preston11-tamu/ECEN404-2026SP-Team-61-HARD/README.md

# TEAM-61-HARD
ECEN 404 Capstone Project: Human Activity Radar Detector (HARD)
