preston11-tamu/ECEN404-2026SP-Team-61-HARD/Power/ALTIUM/README

#Altium files used in the most updated version of power supply
