preston11-tamu/ECEN404-2026SP-Team-61-HARD/Power/MISC/README

#This Contains Random Files which may not have a good spot to be held otherwise but stored in case anyone wants to recreat this project
