preston11-tamu/ECEN404-2026SP-Team-61-HARD/403/presentations/Group 61 Status Update Presentation.pptx

## ECEN 403 Status Update


Team 61: HARD
William Jachimiak, Jean Jacques Chirat, Preston Bowyer, Aiden George
TA: Roman Venegas
Sponsor: Professor Arya Menon

## Project Summary

Problem statement:
- Injury from falling is common in assisted living and can lead to significant issues
- Traditional camera based sensors violate individual’s right to privacy
Our Solution:
- A human fall detector that uses short wave radio and sends alerts via an app
- These detectors can be used in more sensitive areas and prevent privacy violations


## Slide 3

System Overview

Human Radar Unit

Power Supply (Aiden George)

Millimeter Wave Radar Unit

Microcontroller (William Jachimiak)

Neural Network Classification (JJ Chirat)

End User

Mobile Application
(Preston Bowyer)

Firebase Cloud Service

Shared PCB

Deployed on MCU

Flutter Framework

Notes: Cloud server and database

## Machine Learning (Neural Network) Jean Jacques Chirat

Accomplishments since midterm update 40 hrs of effort | Ongoing progress/problems and plans until the next presentation
Finished implementing preprocessing code - binary to .json conversion, calibrating for training parameters, feature scaling | Finish implementing code for neural network Collect ~40 datasets (30 for training, 10 for testing) Train model, evaluate loss & accuracy, set benchmark by the end of this week

## Machine Learning (Neural Network) Jean Jacques Chirat

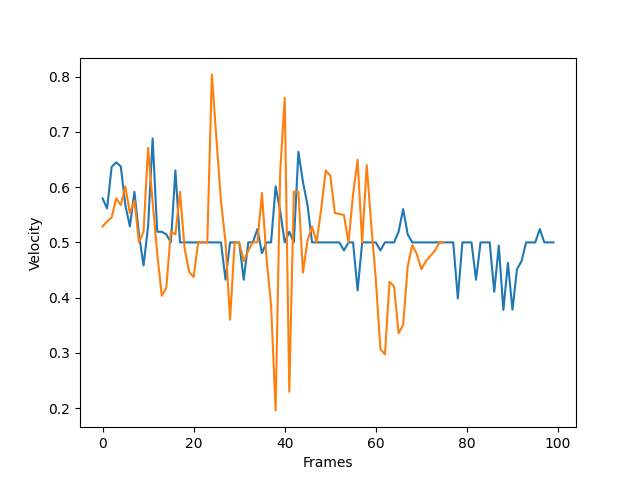
[picture p15: figure]

Data visualized
- Orange is falling pattern
- Blue is non-falling pattern

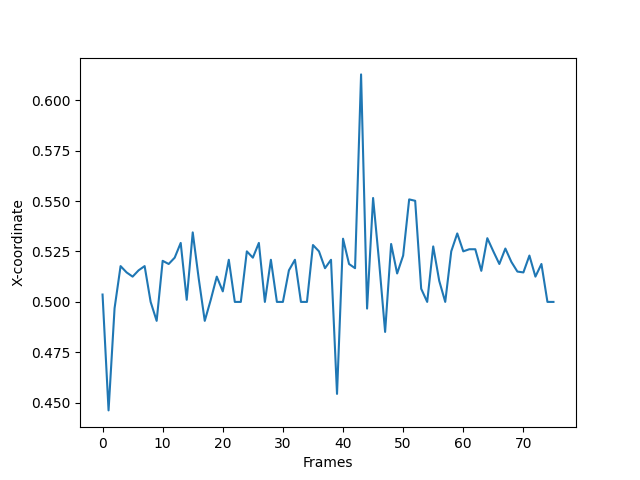
[picture p16: figure]

Falling pattern
- Left is x-coordinate (orientated so that “x” is vertical)
- Right is doppler velocity

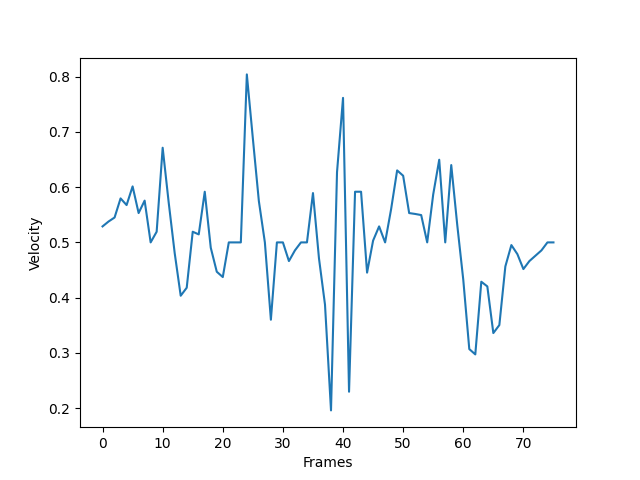
[picture p17: figure]

## MCU/PCB William Jachimiak

Accomplishments since midterm update 40 hrs of effort | Ongoing progress/problems and plans until the next presentation
Finished the schematics tied to the PCB | Finishing the routing of the PCB Plan to start working on getting WIFI output signals from MCU

## MCU/PCB William Jachimiak

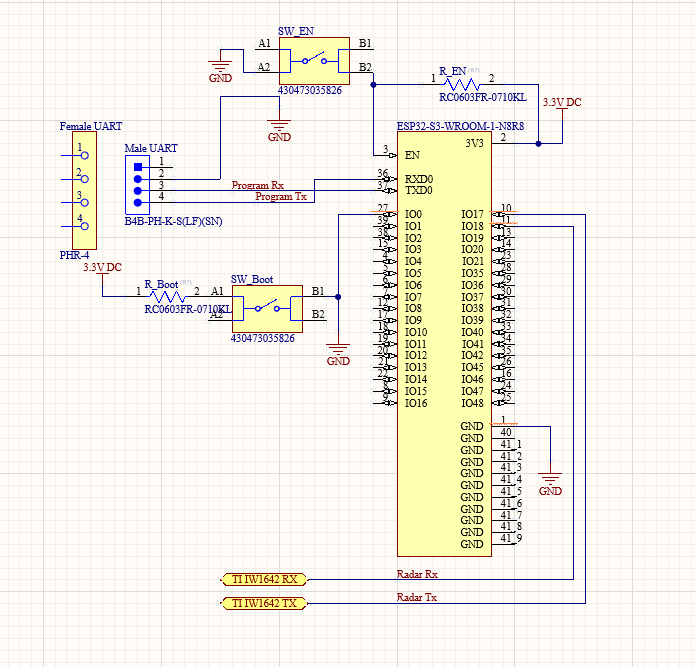
[picture p18: figure]

MCU Schematic

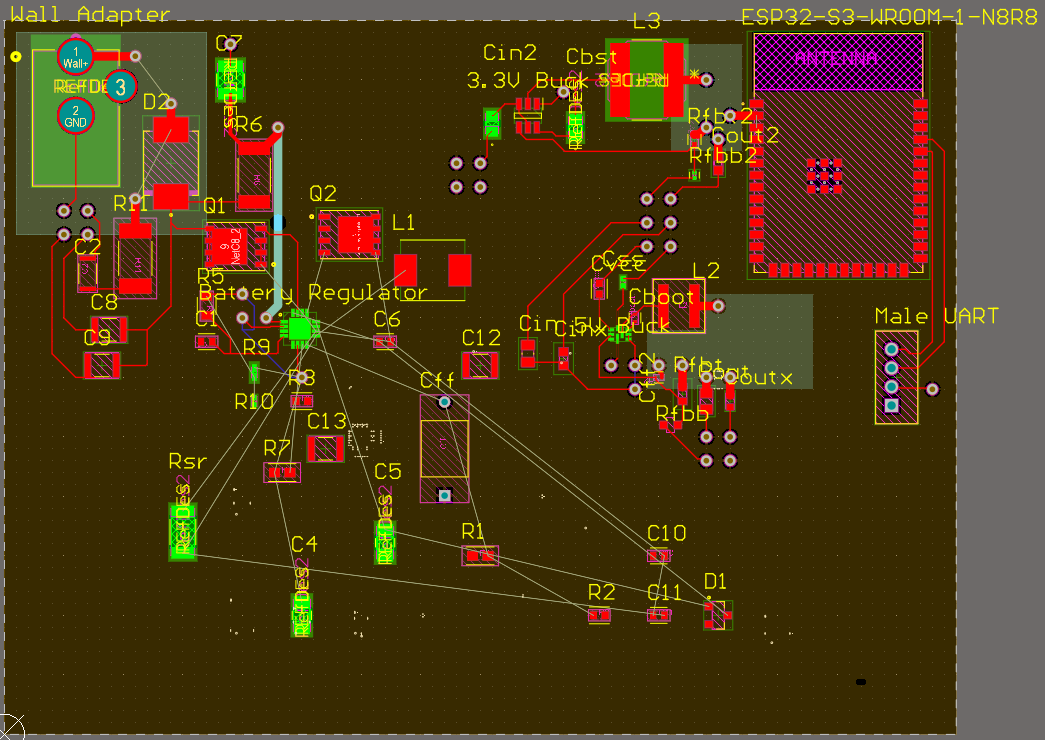
[picture p19: figure]

Current PCB Layout

## Power Supply Aiden George

Accomplishments since midterm update 40 hrs of effort | Ongoing progress/problems and plans until the next presentation
Researched and designed battery charger IC for power supply design Finialized power supply design for PCB Implementation Conducted PSpice simulation of components to validate design for use case

## Subsystem 3 Aiden George

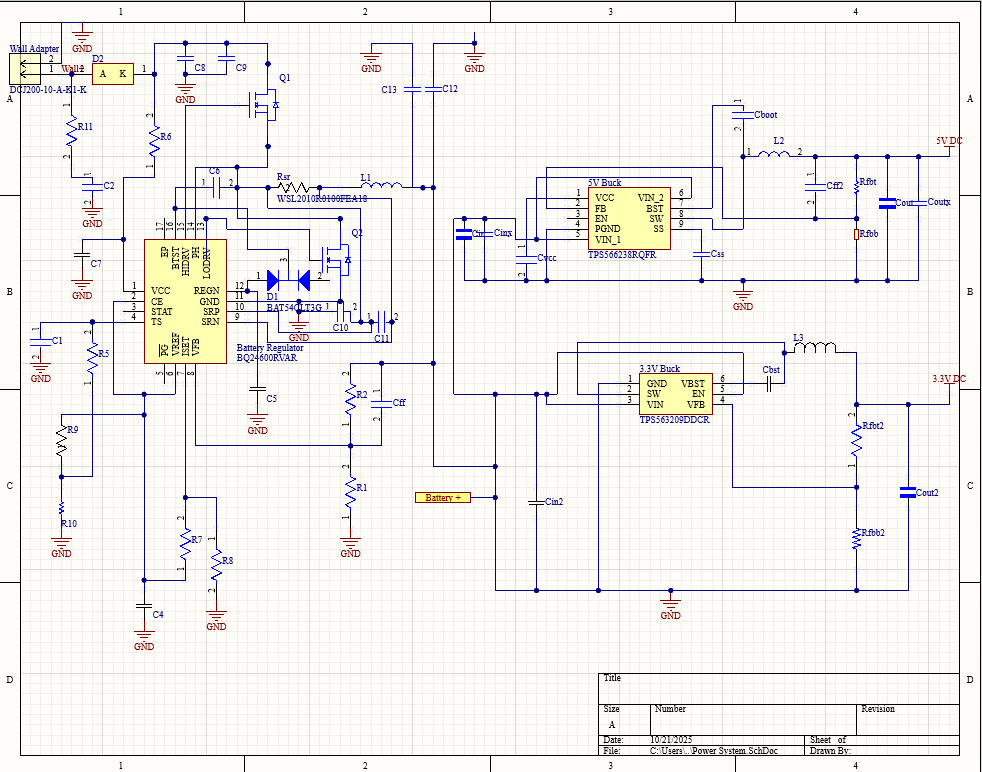
[picture p20: figure]

Power Schematic

## End-User App Preston Bowyer

Accomplishments since midterm update 40 hrs of effort | Ongoing progress/problems and plans until the next presentation
Developed the main UI and successfully deployed the app to an Android device Integrated Firebase Cloud Messaging for real-time alerts on Android Built Firestore alert feed with All, Unread, and Critical filters | Deploy Cloud Function to automatically send FCM alerts for critical events Debugging and validating end-to-end notification reliability across app states and device types Updating the UI to a modern, sleeker look,and planning pagination for for alerts

## End-User App Preston Bowyer

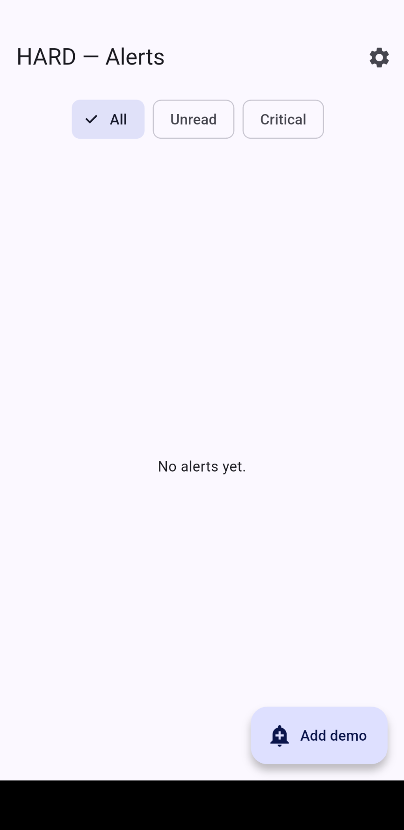
[picture p21: figure]

Cleared alerts page

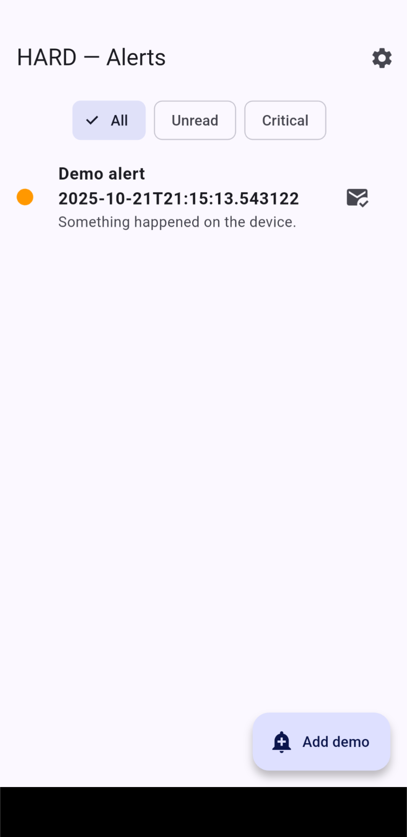
[picture p22: figure]

Alerts page with demo

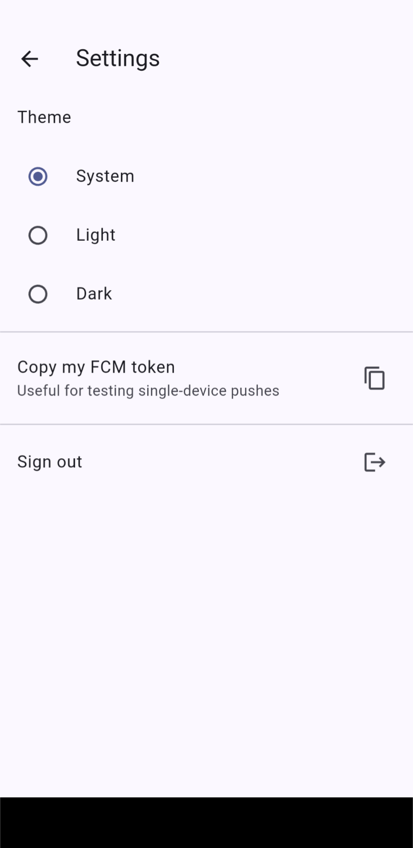
[picture p23: figure]

Settings page

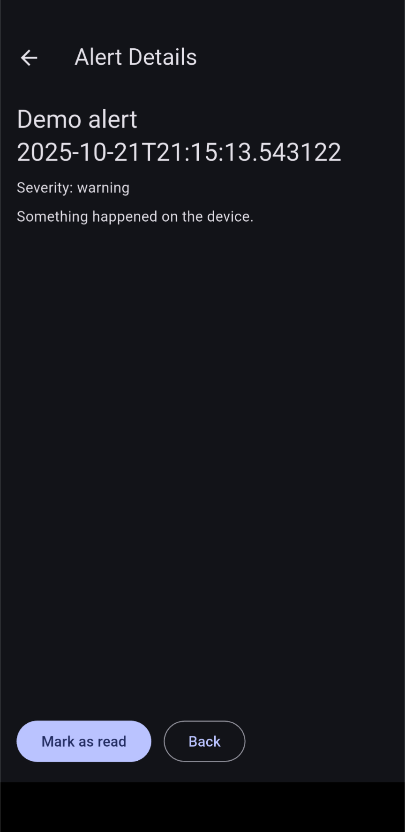
[picture p24: figure]

Dark mode and alert details

## Execution Plan

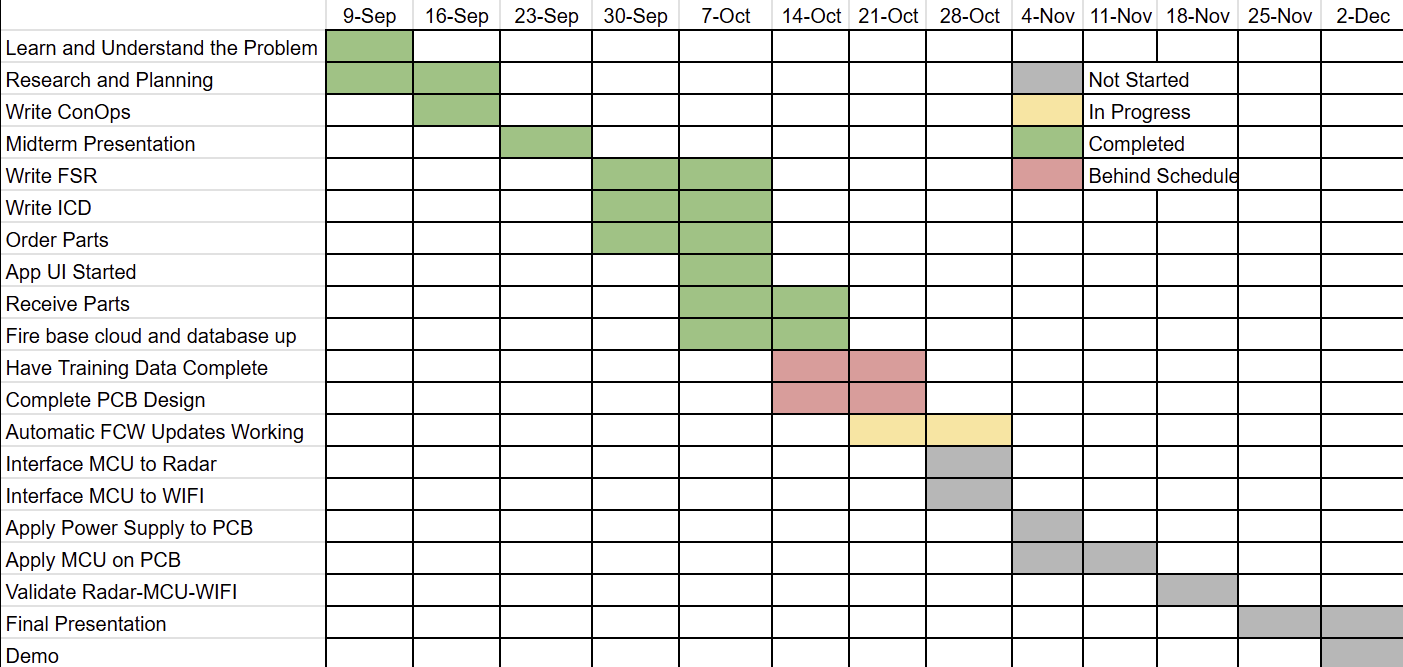
[picture p25: figure]

‹#›

## Validation plan

Task | Specification | Owner
Peak Power | 10 W | Aiden
Radar Detect Distance | 8 M | All
Detection False Positive Rate | ≤ 8% | JJ/William
Detection False Negative Rate | ≤ 5% | JJ/William
Push Notification delivery success | ≥ 99% | Preston
Multi-device fan-out | ± 300ms spread | Preston

‹#›

## Slide 14

Thank you for listening!
Questions & Answers

‹#›
