preston11-tamu/ECEN404-2026SP-Team-61-HARD/404/presentations/Group 61 Status Update #2 ECEN 404.pptx

## Team 61: Project Name Bi-Weekly Update 2 William Jachimiak, Jean Jacques Chirat, Preston Bowyer, Aiden George Sponsor: Professor Arya Menon TA: Manoj Kumar Balamurugan


Notes: Michelle

## Project Summary

- Our project seeks to solve the problem of monitoring fall injury prone individuals in assisted-care through the following implementation:
- Collection of vertical position & velocity data (minimally invasive) using mmWave radar
- Stream the data to Raspberry Pi to be processed by ML detection algorithm
- Pi communicates positive detection result over WiFi network to Firebase cloud
- Firebase interfaces with Android app to notify assisted-care workers if fall event occurs


Notes: Kyle

## Project/Subsystem Overview


Notes: Eric

## Project Timeline

Subsystem Designs and Testing (completed 02/05) | Integration of SBC and ML (to complete by 02/20) | Integration of SBC and App (to complete by 02/20) | Final Integration (to complete by 03/05) | System Test (to complete by 03/26) | Validation (to complete by 04/02) | Demo and Report (to complete by 04/21)

Notes: Eric

## MCU/SBC William Jachimiak

Accomplishments since last update 15 hrs of effort | Ongoing progress/problems and plans until the next presentation
Sent alert over WiFi to the Firebase cloud and created a class to run continuously Ongoing integration with ML | Verifying data transfer to the machine learning class Testing fall detection using real time data

## MCU/SBC William Jachimiak

## Machine Learning Subsystem Jean Jacques Chirat

Accomplishments since last update 8 hrs of effort | Ongoing progress/problems and plans until the next presentation
Adapted existing code onto MCU for ML dataflow Implemented new class & function on MCU to do inferencing on real-time data | Verify that data is 1:1 with model input format Verify that MCU is able to compute prediction result within specified time limit Validate entire data pipeline from radar to ML output (while actually operating)

## Machine Learning Subsystem Jean Jacques Chirat

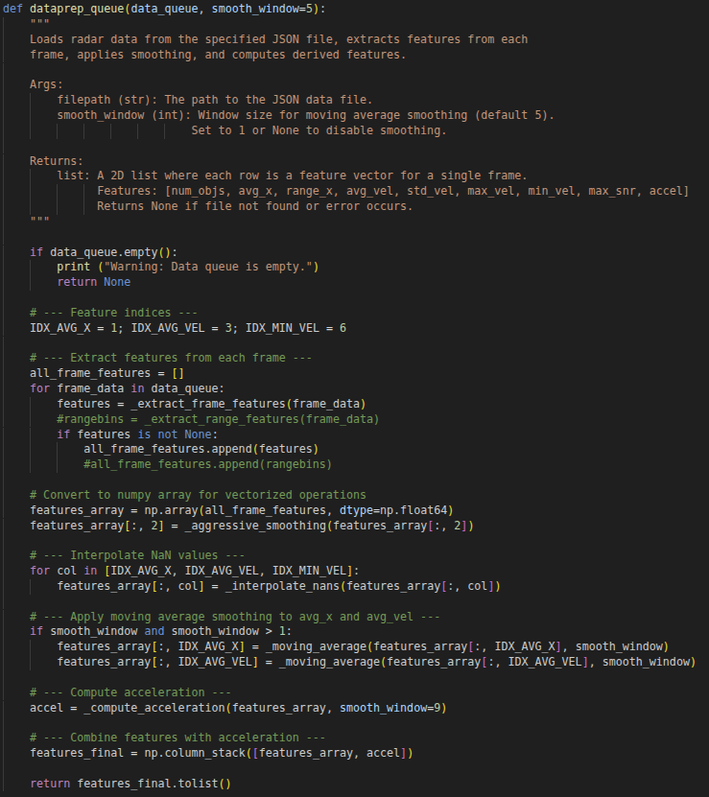
[picture p61: figure]

Preprocessing code adapted for MCU

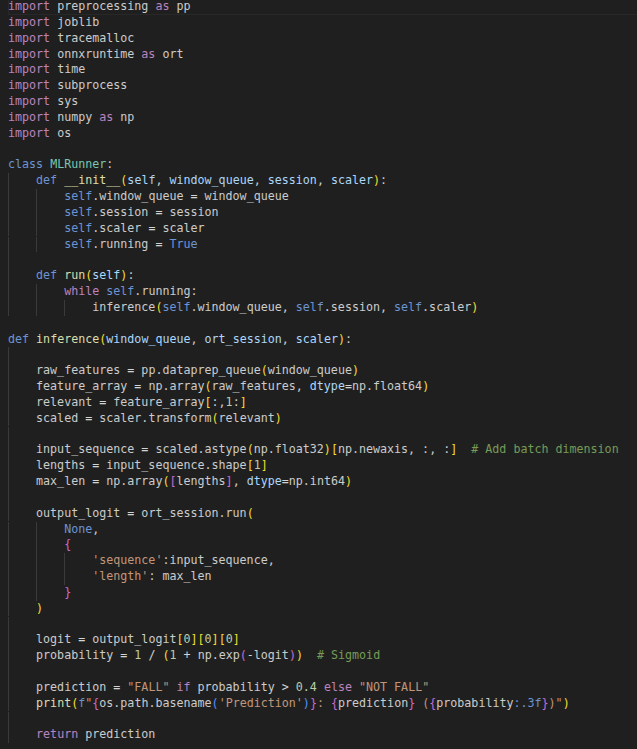
[picture p62: figure]

New code for

## Power Supply Aiden George

Accomplishments since last update 25 hrs of effort | Ongoing progress/problems and plans until the next presentation
Finished redesign and integration of battery charger IC Ordered for parts and board Created CAD design for system enclosure and mounting bracket design for parts | Complete soldering of board and begin validation of design Finish MCU and Radar Bracket Mounts 3D print initial model and ensure fitting of parts

## Power Supply Aiden George

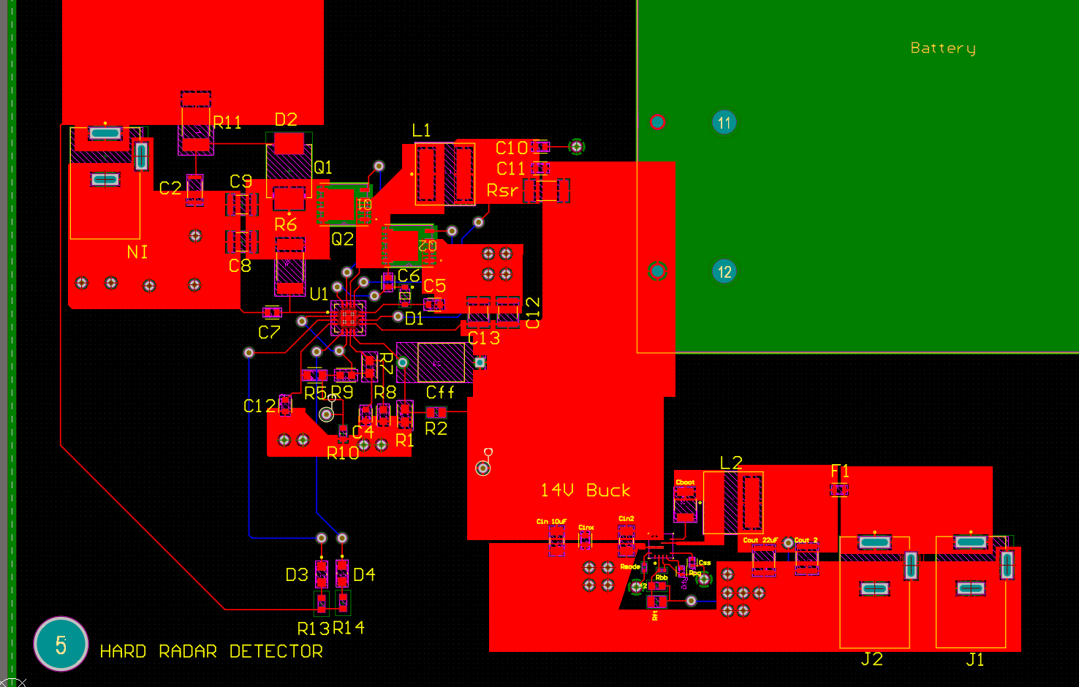
[picture p63: figure]
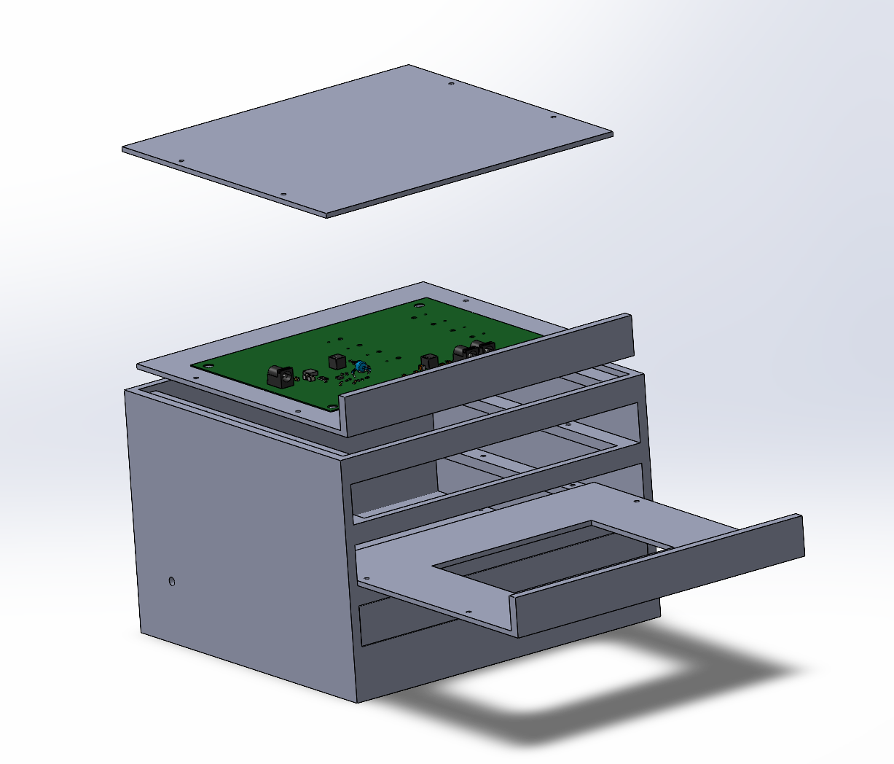
[picture p64: figure]

## End User App Preston Bowyer

Accomplishments since last update 13 hrs of effort | Ongoing progress/problems and plans until the next presentation
Implemented the pipeline for the Raspberry Pi to publish detection and alert data to the cloud backend. Validated that alert data generated on the Pi is reliably written to the database. | Integrating Firestore publishing into the Raspberry Pi’s main detection runtime Refactoring the current standalone publishing script into a reusable module Automating execution on startup to remove manual intervention

## End User App Preston Bowyer

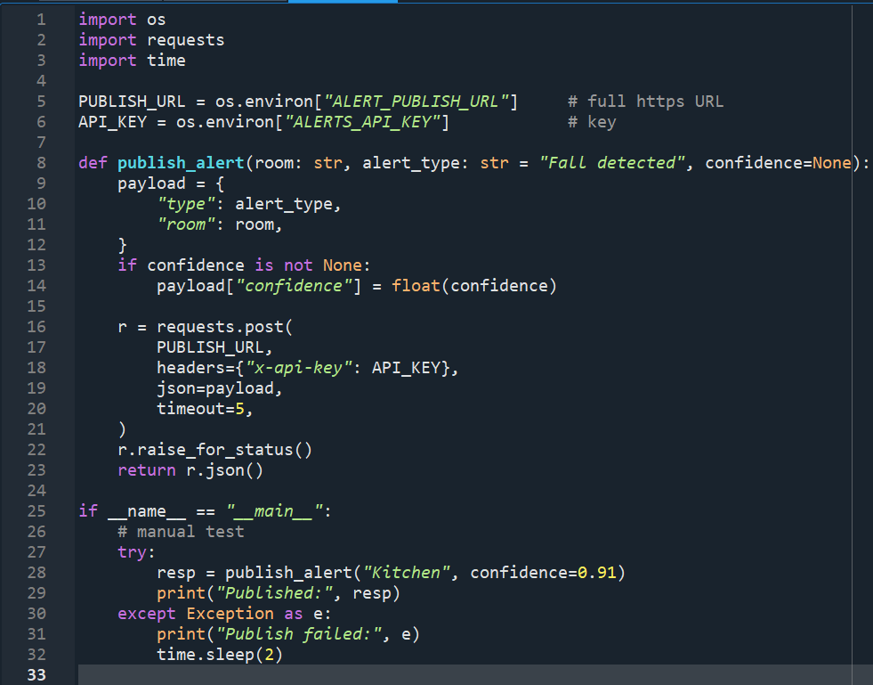
[picture p65: figure]
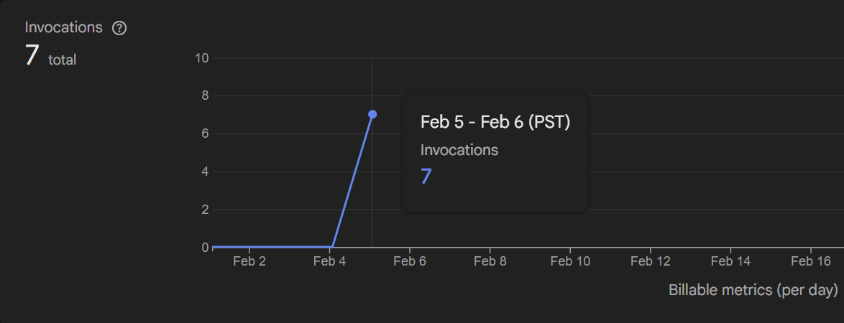
[picture p66: figure]
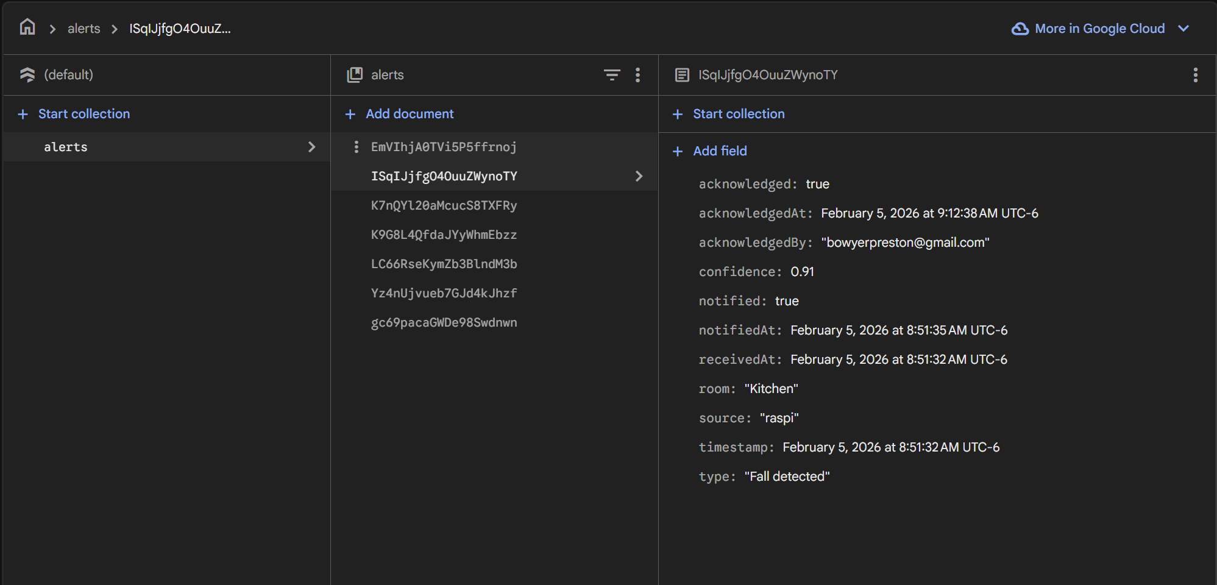
[picture p67: figure]

## Execution Plan

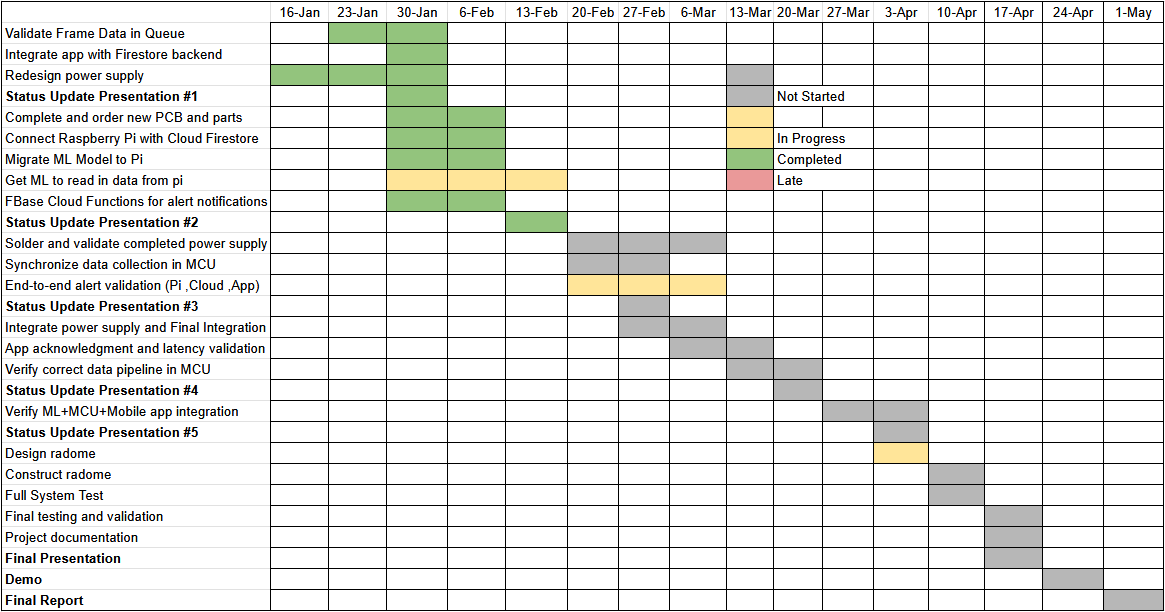
[picture p68: figure]

Notes: Michelle

## Validation Plan

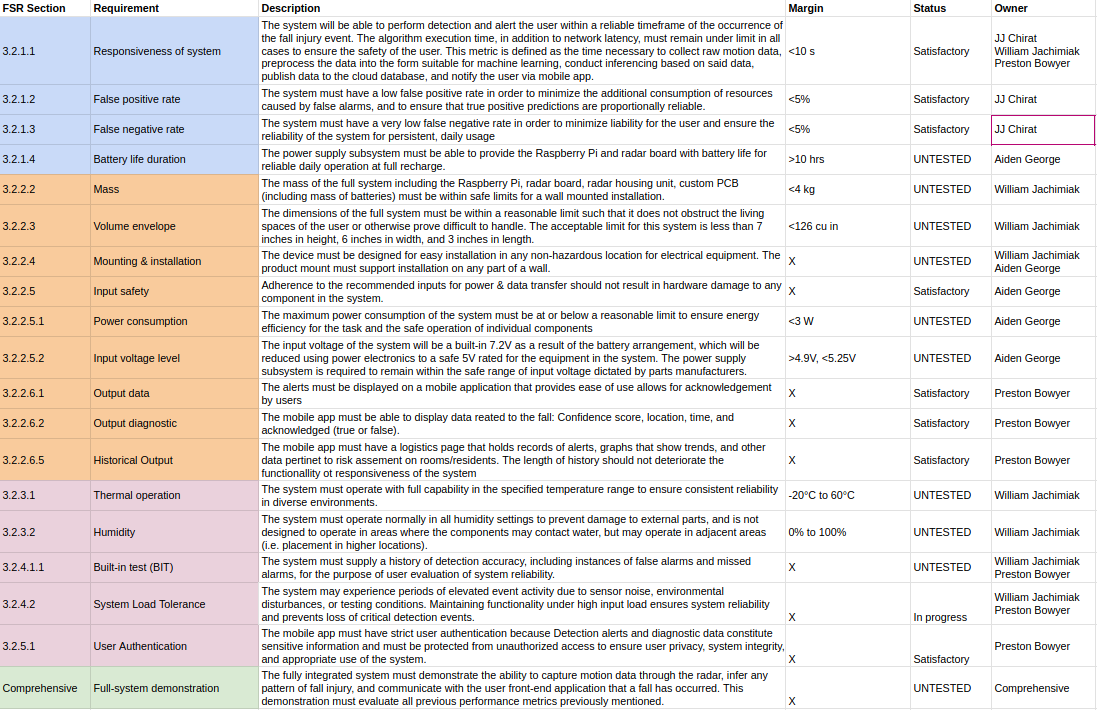
[picture p69: figure]

Notes: Michelle

## Thank you for listening! Q&A
