preston11-tamu/ECEN404-2026SP-Team-61-HARD/403/documents/Power Supply Diagram.jpg

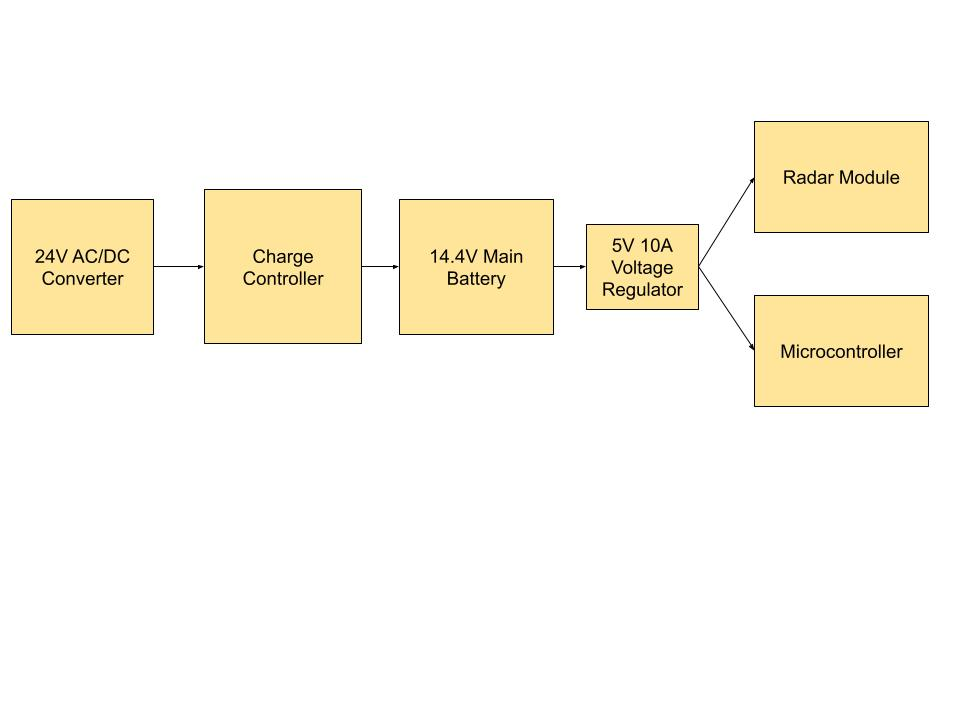
403/documents/Power Supply Diagram.jpg
