preston11-tamu/ECEN404-2026SP-Team-61-HARD/ML/dbscan_animation.gif

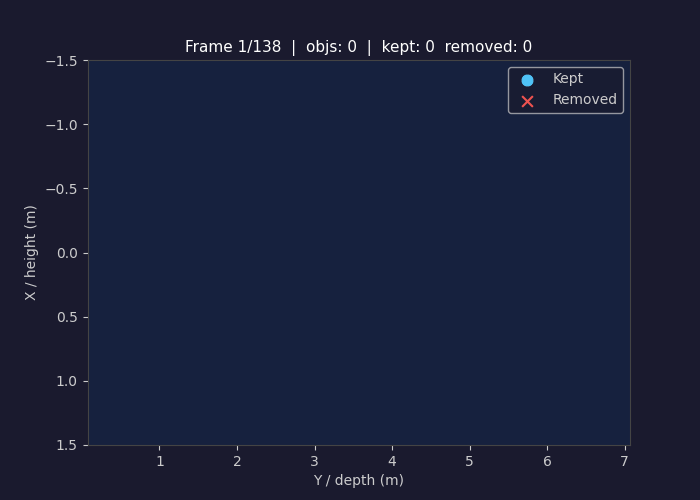
ML/dbscan_animation.gif
