preston11-tamu/ECEN404-2026SP-Team-61-HARD/ML/final_training_loss.png

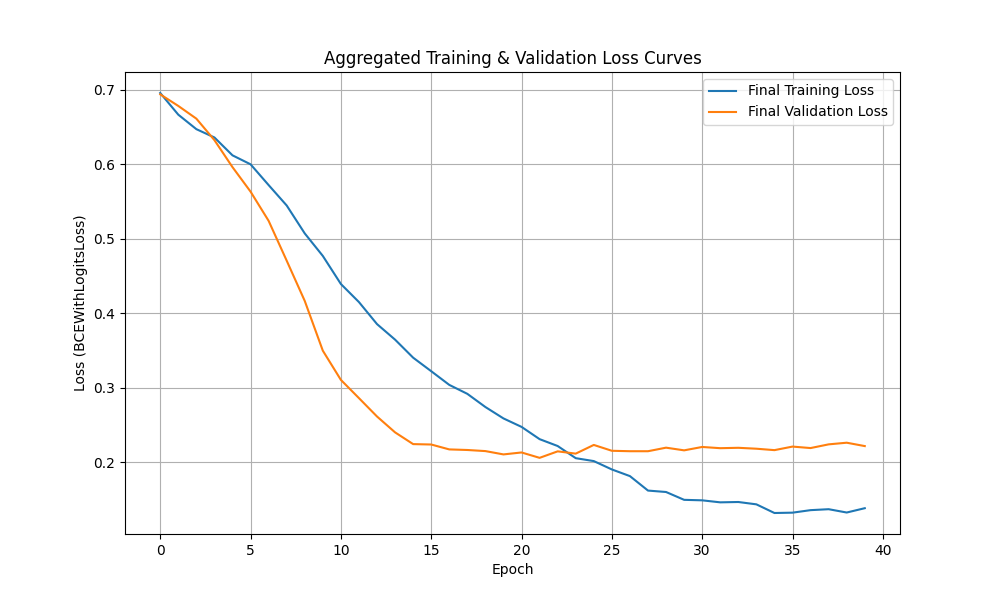
ML/final_training_loss.png
