preston11-tamu/ECEN404-2026SP-Team-61-HARD/ML/fold_accuracy.png

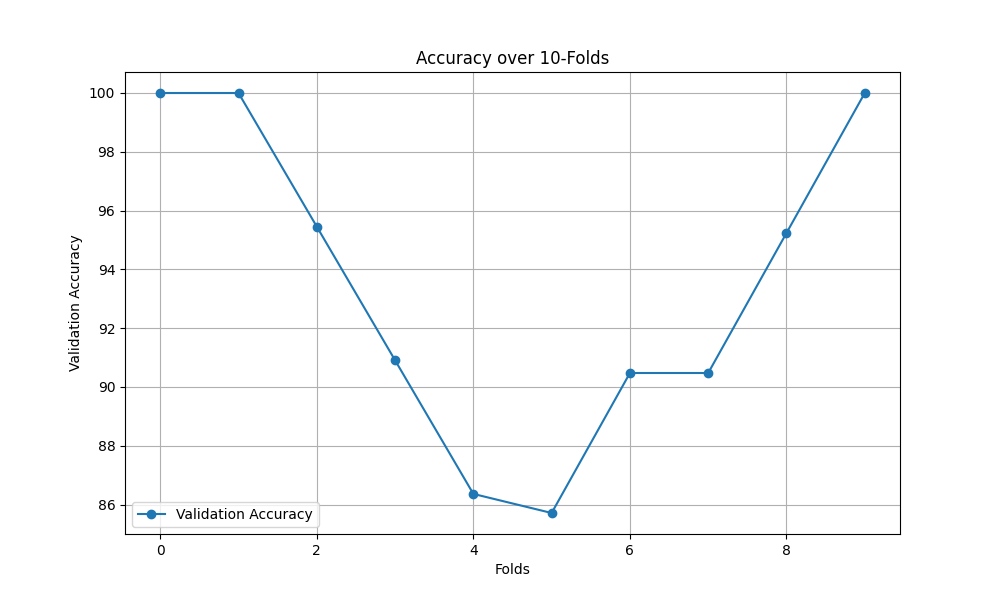
ML/fold_accuracy.png
