preston11-tamu/ECEN404-2026SP-Team-61-HARD/Power/MISC/Capstone V2 BOM.xlsx

 | Description | Designator | Footprint | LibRef | Quantity
Comment | 4.5V to 28V input, 10A synchronous buck converter 10-VQFN-HR -40 to 150 | 14V Buck | RPA0010A-MFG | TPS56A37RPAR | 1
BK-18650-PC8 | No Description Available | Battery | BK-18650-PC8_MPD | BK-18650-PC8 | 1
CGA5L3X7R1H225K160AB | Cap Ceramic 2.2uF 50V X7R 10% Pad SMD 1206 +125°C Automotive T/R | C2 | FP-CGA5L-0_3-0_1-IPC_C | CMP-08246-002495-1 | 1
CC0603KRX7R8BB105 | CAP CER 1UF 25V X7R 0603 | C4, C5 | FP-CC0603-DA-MFG | CMP-2100-03598-2 | 2
C0603C104K4RAC7411 | CAP CER 0.1UF 16V X7R 0603 | C6, C7, C11 | FP-C0603C-CF-MFG | CMP-2006-03724-3 | 3
GRM32ER7YA106KA12L | Chip Capacitor, 10 uF, +/- 10%, 35 V, -55 to 125 degC, 1210 (3225 Metric), RoHS, Tape and Reel | C8, C9, C12, C13 | CAPC3225X270X30LL30 | CMP-1038-02234-2 | 4
C0603C104K5RACTU | CAP CER 0.1UF 50V X7R 0603 | C10 | FP-C0603C-CF-MFG | CMP-2006-03061-2 | 1
CC0603KRX7R8BB104 | CAP CER 0.1UF 25V X7R 0603 | C12 | FP-CC0603-DA-MFG | CMP-03422-000234-1 | 1
C3225X6S1C226M250AC | Multilayer Ceramic Capacitors 22uF ±20% 16V X6S SMD 1210 | Cboot | FP-C3225-250-0_4-MFG | CMP-08246-006992-1 | 1
DE11XRB220KN4AR01F | Cap Ceramic Disc 22pF 10% 500VAC Thru-Hole 6.0x5.0x10.0 Ammo pack | Cff | FP-DE1_D6_T5_F10_d0_6-0_0-MFG | CMP-06035-012369-1 | 1
C0603C151K3GACTU |  | Cff2 | CAPC1608X87X35NL15T15 | CMP-2006-03084-1 | 1
Comment | Chip Multilayer Ceramic Capacitors for General Purpose, 1206, 10uF, X7R, 15%, 10%, 25V | Cin2, Cin 10uF | FP-GRM31C-0_2-e0_3_0_8-IPC_C | CMP-06035-003589-1 | 2
C0603C104M3VACTU | CAP CER 0.1UF 25V Y5V 0603 | Cinx | FP-C0603C-CF-MFG | CMP-2006-03066-2 | 1
Cin | Multilayer Ceramic Capacitors 22uF ±20% 16V X6S SMD 1210 | Cout 2 | FP-C3225-250-0_4-IPC_C | CMP-08246-006992-1 | 1
FEMTOASMDC005F-2 | Multilayer Ceramic Capacitors 22uF ±20% 16V X6S SMD 1210 | Cout 22uF | FP-C3225-250-0_4-IPC_C | CMP-08246-006992-1 | 1
GRM155R71C223KA01D | Chip Multilayer Ceramic Capacitors for General Purpose, 0402, 22000pF, X7R, 15%, 10%, 16V | Css | FP-GRM155-0_05-MFG | CMP-1034-01948-3 | 1
BAT54HT1G | Schottky Barrier Diode, 2-Pin SOD-323, Pb-Free, Tape and Reel | D1 | ONSC-SOD-323-2-477-02_V | CMP-1055-00462-1 | 1
MBRS540T3G | Schottky Power Rectifier, 2-Pin SMC, Pb-Free, Tape and Reel | D2 | ONSC-SMC-2-403-03_V | CMP-1055-00390-1 | 1
LTST-C170GKT | LED GREEN CLEAR SMD | D3, D4 | FP-LTST-C170GKT-MFG | CMP-1674-00002-6 | 2
FEMTOASMDC005F-2 | fuse 0603 | F1 | FP-MCT0603-IPC_C | CMP-02407-009727-1 | 1
PJ-002A | Through Hole Right Angle DC Power Jack, 2.5 A, 2 mm Center Pin, 3 Position, -25 to 85 degC, RoHS, Bulk | IN, J1, J2 | CUI-PJ-002A_V | CMP-2000-06895-2 | 3
XAL7070-332 | Fixed Inductors 3.3uH Shld 20% 25A 2.81mOhms AECQ2 | L2 | FP-XAL7070-MFG | CMP-11268-000195-1 | 1
XAL7070-222 | Fixed Inductors 2.2uH Shld 20% 25A 2.81mOhms AECQ2 | L? | FP-XAL7070-MFG | CMP-11268-000195-1 | 1
SIR426DP-T1-GE3 | N-CHANNEL 40-V (D-S) MOSFET | Q1, Q2 | POWERPAK_SO-8_SINGLE | SIR426DP-T1-GE3 | 2
RR0816P-104-D | 100kΩ ±0.5% 0.0625W 1/16W Chip Resistor 0603 (1608 Metric) Thin Film | R1, R7 | FP-RR0816-IPC_A | CMP-2000-02426-2 | 2
ERA-6AEB6983V | Metal Film Chip Resistor, High Reliability Type, 0.125 W, +/- 0.1%, -55 to 155 degC, 0805 (2012 Metric), RoHS, Tape and Reel | R2 | RESC2013X60X40LL20T25_A | CMP-2001-00582-2 | 1
RR0816P-101-D | 100Ω ±0.5% 0.0625W 1/16W Chip Resistor 0603 (1608 Metric) Thin Film | R5 | FP-RR0816-MFG | CMP-2000-02416-2 | 1
RMCF2512JT10R0 | 10Ω ±5% 1W 2512 Thick Film Chip Resistor AEC-Q200 compliant | R6 | FP-RMCF2512-IPC_B | CMP-26527-002316-1 | 1
ERA-3AEB4122V | RES SMD 9.31KOHM 0.1% 1/10W 0603 | R8 | FP-ERA3A-IPC_B | CMP-05422-000141-1 | 1
ERA-3AEB9311V | RES SMD 9.31KOHM 0.1% 1/10W 0603 | R9 | FP-ERA3A-IPC_B | CMP-05422-000141-1 | 1
442K 1% 0603(1608) | 442K 0.1W 1% 0603 (1608 Metric) SMD | R10 | RESC0603(1608)_L | CMP-1012-00809-1 | 1
RMCF2512JT2R00 | 2Ω ±5% 1W 2512 Thick Film Chip Resistor AEC-Q200 compliant | R11 | FP-RMCF2512-IPC_A | CMP-26527-006700-1 | 1
RC0603JR-0710KL | 10K 0.05W 1% 0201 (0603 Metric) SMD | R13, R14 | RESC1608X55X25ML10T15 | CMP-2000-05022-1 | 2
10K 1% 0201(0603) |  | Rbb | RESC0201(0603)_N | CMP-1010-00642-1 | 1
ERJ-6ENF7322V |  | Rft | RESC2013X70X40LL20T20 | CMP-2001-00287-1 | 1
CRCW040252K3FKED |  | Rmode | RESC1005X40X25LL05T05 | CMP-2002-00086-1 | 1
CRCW0402100KFKED | RES Thick Film, 100kΩ, 1%, 0.063W, 100ppm/°C, 0402 | Rpg | FP-CRCW0402-e3-IPC_C | CMP-2002-08123-3 | 1
WSL2010R0100FEA | Chip Resistor, 10 mOhm, +/- 1%, 0.5 W, -65 to 170 degC, 2010 (5025 Metric), RoHS, Tape and Reel | Rsr | RESC5125X89X51LL25T25 | CMP-2000-07418-1 | 1
BQ24600RVAT | IC SYNC SW-MODE BAT CHRGR 16VQFN | U1 | FP-RVA0016A-MFG | CMP-0321-00211-3 | 1
