preston11-tamu/ECEN404-2026SP-Team-61-HARD/403/documents/Copy of ECEN 403 Budget  (1).xlsx

 | Components Cost
 | Mouser # | Mfr. # | Manufacturer | Customer # | Description | RoHS | Lifecycle | Order Qty. | Price (USD) | Ext.: (USD) | Estimated Tariff Price (USD) | Estimated Tariff Ext. (USD)
1 | 595-TPS566238RQFR | TPS566238RQFR | Texas Instruments |  | Switching Voltage Regulators 3-V to 18-V input 6 -A synchronous step- | RoHS Compliant |  | 3 | $0.96 | $2.88 | $0.54 | $1.61
2 | 595-TPS563209DDCR | TPS563209DDCR | Texas Instruments |  | Switching Voltage Regulators 17 V Input 3A SOT-2 3 6-SOT -40to85 A 595-TPS563209DDCT | RoHS Compliant |  | 3 | $1.02 | $3.06 | $0.57 | $1.71
3 | 781-SIR426DP-GE3 | SIR426DP-T1-GE3 | Vishay |  | MOSFETs 40V Vds 20V Vgs PowerPAK SO-8 | RoHS Compliant By Exemption |  | 6 | $1.26 | $7.56 | $0.71 | $4.24
4 | 637-BAT54C | BAT54C | Diotec Semiconductor |  | Schottky Diodes & Rectifiers Schottky, SOT-23, 30V, 0.2A | RoHS Compliant |  | 1 | $0.12 | $0.12 | $0.07 | $0.07
5 | 863-MBRS540T3G | MBRS540T3G | onsemi |  | Schottky Diodes & Rectifiers 5A 40V | RoHS Compliant By Exemption |  | 3 | $0.40 | $1.20 | $0.07 | $0.20
6 | 71-WSL2010-0.01-E3 | WSL2010R0100FEB | Vishay |  | Current Sense Resistors - SMD 1/2watt .01ohms 1% | RoHS Compliant |  | 3 | $1.61 | $4.83
7 | 595-BQ24600RVAR | BQ24600RVAR | Texas Instruments |  | Battery Management Standalone Synch Sw- mode Charge Cntrlr A 595-BQ24600RVAT | RoHS Compliant |  | 3 | $2.25 | $6.75
8 | 954-103AT-2 | 103AT-2 | Semitec |  | NTC Thermistors 10kohm 1% | RoHS Compliant By Exemption |  | 3 | $0.58 | $1.74
9 | 70-IHLP2525CZR3R3M8A | IHLP2525CZER3R3M8A | Vishay |  | Power Inductors - SMD 3.3uH 20% | RoHS Compliant |  | 3 | $1.06 | $3.18 | $0.60 | $1.81
10 | 963-GMJ316BB7106KLHT | GMJ316BB7106KLHT | TAIYO YUDEN |  | Multilayer Ceramic Capacitors MLCC - SMD/SMT 963-MCJCG31LBB7106KT RPLCMT PN 35V 10uF X7R 1206 AEC-Q200 | RoHS Compliant |  | 10 | $0.46 | $4.61
11 | 963-MLASE168SB7105KT | MLASE168SB7105KTNA01 | TAIYO YUDEN |  | Multilayer Ceramic Capacitors MLCC - SMD/SMT 16V 1uF X7R 0603 10% Medical | RoHS Compliant |  | 2 | $0.11 | $0.22 | $0.05 | $0.11
12 | 603-AC1206KKX7R9BB22 | AC1206KKX7R9BB225 | YAGEO |  | Multilayer Ceramic Capacitors MLCC - SMD/SMT 50V 2.2uF X7R 1206 10% AEC-Q200 HI CV | RoHS Compliant |  | 1 | $0.78 | $0.78
13 | 810-C1608X7R1H105K08 | C1608X7R1H105K080AB | TDK |  | Multilayer Ceramic Capacitors MLCC - SMD/SMT Commercial Grade,MLCC,0603,X7R,50V,1uF,+/-10%,0.8mm | RoHS Compliant | New Product | 1 | $0.23 | $0.23 | $0.04 | $0.04
14 | 603-CC402KRX7R7BB104 | CC0402KRX7R7BB104 | YAGEO |  | Multilayer Ceramic Capacitors MLCC - SMD/SMT 16 V 0.1uF X7R 0402 10% | RoHS Compliant |  | 4 | $0.10 | $0.40
15 | 581-04025C220KAT2A | 04025C220KAT2A | KYOCERA AVX |  | Multilayer Ceramic Capacitors MLCC - SMD/SMT 50V 22pF X7R 0402 10 % | RoHS Compliant |  | 1 | $0.27 | $0.27
16 | 963-MAJCU168BB7104KT | MAJCU168BB7104KTEA01 | TAIYO YUDEN |  | Multilayer Ceramic Capacitors MLCC - SMD/SMT 50V 0.1uF 0603 X7R 10% AECQ2 | RoHS Compliant | New Product | 9 | $0.11 | $0.99 | $0.02 | $0.14
17 | 652-SRN8040-2R2Y | SRN8040-2R2Y | Bourns |  | Power Inductors - SMD 2.2uH 30% SMD 8040 | RoHS Compliant |  | 3 | $0.53 | $1.59 | $0.14 | $0.43
18 | 708-RMCF2512JT2R00 | RMCF2512JT2R00 | SEI Stackpole |  | Thick Film Resistors - SMD 2Ohms 2512 1W 5% Std Power AEC-Q200 | RoHS Compliant By Exemption |  | 2 | $0.20 | $0.40
19 | 71-CRCW251210R0JNGIF | CRCW251210R0JNEGIF | Vishay |  | Thick Film Resistors - SMD CRCW2512-IF 200 10R 5% E67 e3 | RoHS Compliant | New Product | 6 | $0.86 | $5.16 | $0.12 | $0.72
20 | 754-RR0816P-101D | RR0816P-101-D | Susumu |  | Thin Film Resistors - SMD 1/16W 100ohm 0.5% 25ppm | RoHS Compliant |  | 9 | $0.10 | $0.90
21 | 603-RT0603BRD0741K7L | RT0603BRD0741K7L | YAGEO |  | Thin Film Resistors - SMD 41.7 kOhms 25PPM/C 100mW 0603 10% | RoHS Compliant By Exemption |  | 3 | $0.14 | $0.42 | $0.05 | $0.15
22 | 75-M55342K11B10E0RS3 | M55342K11B10E0RS3 | Vishay |  | Thick Film Resistors - SMD 0402 10K 1% | No |  | 13 | $0.93 | $12.14 | $0.13 | $1.70
23 | 754-RR0816P-304D | RR0816P-304-D | Susumu |  | Thin Film Resistors - SMD 1/16W 300Kohm 0.5% 25ppm | RoHS Compliant |  | 3 | $0.10 | $0.30 | $0.01 | $0.03
24 | 754-RR0816P-104D | RR0816P-104-D | Susumu |  | Thin Film Resistors - SMD 1/16W 100Kohm 0.5% 25ppm | RoHS Compliant |  | 11 | $0.02 | $0.25
25 | 708-RMCF0402FT9K31 | RMCF0402FT9K31 | SEI Stackpole |  | Thick Film Resistors - SMD 9.31KOhms 0402 0.0625W 1% Std Power AEC-Q200 | RoHS Compliant By Exemption |  | 6 | $0.10 | $0.60 | $0.05 | $0.27
26 | 603-RC0402FR-07442KL | RC0402FR-07442KL | YAGEO |  | Thick Film Resistors - SMD General Purpose Chip Resistor 0402, 442kOhms, 1%, 1/16W | RoHS Compliant By Exemption |  | 3 | $0.10 | $0.30 | $0.04 | $0.11
27 | 71-WSL2010R0100FEA18 | WSL2010R0100FEA18 | Vishay |  | Current Sense Resistors - SMD 1watt .01ohms 1% | RoHS Compliant |  | 9 | $1.44 | $12.96
28 | 708-RMCF2512JT10R0 | RMCF2512JT10R0 | SEI Stackpole |  | Thick Film Resistors - SMD 10Ohms 2512 1W 5% Std Power AEC-Q200 | RoHS Compliant By Exemption |  | 10 | $0.06 | $0.61 | $0.01 | $0.07
29 | 667-ERJ-S02F3322X | ERJ-S02F3322X | Panasonic |  | Thick Film Resistors - SMD 0402 33.2Kohms 1% Anti-Sulfur | RoHS Compliant By Exemption |  | 3 | $0.37 | $1.11
30 | 603-RC0603FR-07220KL | RC0603FR-07220KL | YAGEO |  | Thick Film Resistors - SMD General Purpose Chip Resistor 0603, 220kOhms, 1%, 1/10W | RoHS Compliant By Exemption |  | 3 | $0.10 | $0.30 | $0.04 | $0.11
31 | 81-GRM188R60J226ME0D | GRM188R60J226MEA0D | Murata |  | Multilayer Ceramic Capacitors MLCC - SMD/SMT 22 uF 6.3 VDC 20% 0603 X5R | RoHS Compliant |  | 3 | $0.15 | $0.45 | $0.02 | $0.06
32 | 581-08053C104K | 08053C104KAT2A | KYOCERA AVX |  | Multilayer Ceramic Capacitors MLCC - SMD/SMT KGM21NR71E104KT NEW GLOBAL PN 25V 0.1uF A 581-KGM21NR71E104KT | RoHS Compliant By Exemption |  | 3 | $0.10 | $0.30 | $0.01 | $0.03
33 | 963-MSAST219LB5106KT | MSAST219LB5106KTNA01 | TAIYO YUDEN |  | Multilayer Ceramic Capacitors MLCC - SMD/SMT 25V 10uF X5R 0805 10% | RoHS Compliant |  | 16 | $0.15 | $2.37 | $0.02 | $0.32
34 | 963-MAJCH168BB7104KT | MAJCH168BB7104KTEA01 | TAIYO YUDEN |  | Multilayer Ceramic Capacitors MLCC - SMD/SMT 100V 0.1uF 0603 X7R 10% AECQ2 | RoHS Compliant | New Product | 12 | $0.06 | $0.68 | $0.01 | $0.10
35 | 963-LMK212BJ226MG-T | LMK212BJ226MG-T | TAIYO YUDEN |  | Multilayer Ceramic Capacitors MLCC - SMD/SMT 10V 22uF X5R 0805 20 % | RoHS Compliant |  | 3 | $0.35 | $1.05 | $0.06 | $0.18
36 | 581-06033A330JAT2A | 06033A330JAT2A | KYOCERA AVX |  | Multilayer Ceramic Capacitors MLCC - SMD/SMT KGM15ACG1E330JT NEW GLOBAL PN 25V 33pF C A 581-KGM15ACG1E330JT | RoHS Compliant |  | 3 | $0.14 | $0.42 | $0.01 | $0.04
37 | 81-GRM36X103K16 | GRM155R71C103KA01D | Murata |  | Multilayer Ceramic Capacitors MLCC - SMD/SMT 0.01 uF 16 VDC 10% 0402 X7R | RoHS Compliant |  | 3 | $0.10 | $0.30 | $0.02 | $0.05
38 | 963-EMK107B7105KA-T | EMK107B7105KA-T | TAIYO YUDEN |  | Multilayer Ceramic Capacitors MLCC - SMD/SMT 963-MSASE168SB7105KT RPLCMT PN 16V 1uF X7R 0603 10% | RoHS Compliant |  | 3 | $0.10 | $0.30 | $0.05 | $0.15
 |  |  |  |  |  |  |  |  |  |  | Merchandise: | $81.73
 |  |  |  |  |  |  |  |  |  |  | Shipping Charge: | $26.99
 |  |  |  |  |  |  |  |  |  |  | Estimated Tariff: | $14.45
 | Battery Cost
 | Description |  |  |  |  |  |  | Qty. | Price (USD) | Total Price
 | Samsung 50S 21700 5000mAh 25A Battery (https://www.18650batterystore.com/products/samsung-50s-21700-5000mah-25a-battery?variant=42183459897495) |  |  |  |  |  |  | 4 | $3.85 | $15.50
 |  |  |  |  |  |  |  |  |  |  | Merchandise: | $15.50
 |  |  |  |  |  |  |  |  |  |  | Shipping Charge: | $9.58
 | SBC Cost |  |  |  |  |  |  | Qty. | Price (USD) | Total Price
 | Description |  |  |  |  |  |  |  |  | 0
1 | https://www.digikey.com/en/products/detail/raspberry-pi/SC1432/21658257 |  |  |  |  |  |  | 1 | $80.00 | $80.00
2 | https://www.digikey.com/en/products/detail/raspberry-pi/SC1153/21658276 |  |  |  |  |  |  | 1 | $12.00 | $12.00 | Merchandise: | $122.51
3 | https://www.digikey.com/en/products/detail/mikroelektronika/MIKROE-5172/16528243 |  |  |  |  |  |  | 1 | $15.60 | $15.60 | Shipping Charge: | $6.99
4 | https://www.digikey.com/en/products/detail/raspberry-pi/SC0546/13901220 |  |  |  |  |  |  | 1 | $5.00 | $5.00 | Estimated Tariff: | $0.50
 | Mouser Order
1 | 595-BQ24600RVAR | BQ24600RVAR | Texas Instruments |  | Battery Management Standalone Synch Sw- mode Charge Cntrlr A 595-BQ24600RVAT | RoHS Compliant |  | 3 | $2.56 | $7.68
2 | 595-TPS56A37RPAR | TPS56A37RPAR | Texas Instruments |  | Switching Voltage Regulators 4.5V to 28V input 1 0A synchronous buck | RoHS Compliant |  | 2 | $2.89 | $5.78 | $1.62 | $3.24
3 | 667-ERA-6AEB6983V | ERA-6AEB6983V | Panasonic |  | Thin Film Resistors - SMD 0805 698Kohm 0.1% 25ppm | RoHS Compliant By Exemption |  | 10 | $0.05 | $0.54
4 | 781-SIR426DP-GE3 | SIR426DP-T1-GE3 | Vishay |  | MOSFETs 40V Vds 20V Vgs PowerPAK SO-8 | RoHS Compliant By Exemption |  | 6 | $1.57 | $9.42 | $0.88 | $5.27
5 | 358-SC1148 | SC1148 | Raspberry Pi |  | Heat Sinks Raspberry Pi Active Cooler | RoHS Compliant |  | 1 | $5.00 | $5.00 | $1.80 | $1.80
 |  |  |  |  |  |  |  |  |  |  | Merchandise: | $28.42
 | Description |  |  |  |  |  |  | Qty. | Price (USD) | Total Price
 | E-outstanding Right Angle Power Jack 2PCS 90 Degree Angle 5.5x2.1mm Female Jack to 5.5x2.1mm Male Plug Adapter DC Barrel Charging Cable Connector |  |  |  |  |  |  | 1 | $6.99 | $6.99
 |  |  |  |  |  |  |  |  |  |  | Merchandise: | $6.99
 |  |  |  |  |  |  |  |  |  |  | Shipping Charge: | $0.58
