preston11-tamu/ECEN404-2026SP-Team-61-HARD/404/documents/All Tests Doc.xlsx

Sheet: 0414
Test # | No Fall Cases | Result |  | Fall Test # | Result | Time (Seconds) | Confidence | Average Time
1 | Walking | No Fall |  | 1 | Fall | 6 |  | 6.75
2 | Walking | No Fall |  | 2 | Fall | 20
3 | Walking | No Fall |  | 3 | Fall | 3
4 | Standing | No Fall |  | 4 | Fall | 7
5 | Standing | No Fall |  | 5 | No Fall | X
6 | Standing | No Fall |  | 6 | Fall | 4
7 | Standing | No Fall |  | 7 | Fall | 10
8 | Standing | Fall |  | 8 | Fall | 12
9 | Walking | No Fall |  | 9 | Fall | 5
10 | Walking | No Fall |  | 10 | Fall | 5
11 | Walking | No Fall |  | 11 | Fall | 17
12 | Walking | No Fall |  | 12 | No Fall | X
13 | Walking | No Fall |  | 13 | Fall | 7
14 | Walking | No Fall |  | 14 | Fall | 1
15 | Walking | No Fall |  | 15 | Fall | 3
16 | Close Parallel Walk | Fall |  | 16 | Fall | 6 | 99
17 | Wall Sit | No Fall |  | 17 | Fall | 4 | 86
18 | Wall Sit | No Fall |  | 18 | Fall | 1 | 90
19 | Wall Sit | No Fall | ML Junk | 19 | Fall | 9 | 99
20 | Wall Sit (Quicker) | No Fall |  | 20 | Fall | 9 | 99
21 | Jump | No Fall |  | 21 | Fall | 7 | 99
22 |  |  |  | 22 | Fall | 3 | 75
23 |  |  |  | 23 | Fall | 7 | 99
24 |  |  |  | 24 | Fall | 7 | 99
25 |  |  |  | 25 | Fall | 6 | 99
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
