preston11-tamu/ECEN404-2026SP-Team-61-HARD/404/documents/User Auth Test.xlsx

Test # | Test Type | Result
1 | Valid Login Credentials | Login Success
2 | Valid Login Credentials | Login Success
3 | Valid Login Credentials | Login Success
4 | Valid Login Credentials | Login Success
5 | Valid Login Credentials | Login Success
6 | Valid Login Credentials | Login Success
7 | Valid Login Credentials | Login Success
8 | Valid Login Credentials | Login Success
9 | Valid Login Credentials | Login Success
10 | Valid Login Credentials | Login Success
11 | Valid Login Credentials | Login Success
12 | Valid Login Credentials | Login Success
13 | Valid Login Credentials | Login Success
14 | Valid Login Credentials | Login Success
15 | Valid Login Credentials | Login Success
16 | Invalid Login Credentials | Login Failed
17 | Invalid Login Credentials | Login Failed
18 | Invalid Login Credentials | Login Failed
19 | Invalid Login Credentials | Login Failed
20 | Invalid Login Credentials | Login Failed
21 | Invalid Login Credentials | Login Failed
22 | Invalid Login Credentials | Login Failed
23 | Invalid Login Credentials | Login Failed
24 | Invalid Login Credentials | Login Failed
25 | Invalid Login Credentials | Login Failed
26 | Invalid Login Credentials | Login Failed
27 | Invalid Login Credentials | Login Failed
28 | Invalid Login Credentials | Login Failed
29 | Invalid Login Credentials | Login Failed
30 | Invalid Login Credentials | Login Failed
