preston11-tamu/ECEN404-2026SP-Team-61-HARD/(list of files, drawings)

Other design files:
Power/CAP.DSN
Power/Capstone PCB.PcbDoc
Power/MISC/Microcontroller.SchDoc
Power/MISC/Power System2.SchDoc
Power/MISC/Power System.SchDoc
