preston11-tamu/ECEN404-2026SP-Team-61-HARD/SBC-Radar/preprocessing.py

import json
from scipy.signal import savgol_filter, medfilt
from sklearn.cluster import DBSCAN
import numpy as np

def _moving_average(data, window_size):
    """
    Apply a centered moving average filter to smooth the data.
    Uses reflection padding to handle edge effects.
    """
    if len(data) == 0 or window_size <= 1:
        return data
    
    kernel = np.ones(window_size) / window_size
    padded = np.pad(data, window_size // 2, mode='reflect')
    return np.convolve(padded, kernel, mode='valid')


def _interpolate_nans(arr):
    """
    Linearly interpolate NaN values in a 1D array.
    Edge NaNs are filled with nearest valid value.
    """
    nan_mask = np.isnan(arr)
    
    if not nan_mask.any():
        return arr
    if nan_mask.all():
        return np.zeros_like(arr)
    
    x = np.arange(len(arr))
    valid_mask = ~nan_mask
    arr[nan_mask] = np.interp(x[nan_mask], x[valid_mask], arr[valid_mask])
    return arr

def _remove_outliers(objects, m=2.0):
    """
    Removes spatial outliers from a list of object dictionaries based on 
    distance from the frame's centroid.
    """
    if len(objects) < 4:
        return objects

    coords = np.array([[obj.x, obj.y] for obj in objects])
    centroid = np.mean(coords, axis=0)
    distances = np.linalg.norm(coords - centroid, axis=1)
    
    mean_dist = np.mean(distances)
    std_dist = np.std(distances)
    threshold = mean_dist + (m * std_dist)
    
    clean_objects = []
    for i, obj in enumerate(objects):
        if distances[i] <= threshold:
            clean_objects.append(obj)
            
    return clean_objects

def compute_rcs(x_vals, y_vals, snr_vals):
    """
    Computes a relative proxy for Radar Cross Section (RCS) using the radar equation.
    Assuming the standard relationship: RCS_dB = SNR_dB + 40 * log10(R)
    
    Args:
        x_vals (np.ndarray): Array of X coordinates.
        y_vals (np.ndarray): Array of Y coordinates.
        snr_vals (np.ndarray): Array of SNR values.
        
    Returns:
        np.ndarray: Array of estimated relative RCS values.
    """
    # Calculate range (distance from radar) R = sqrt(x^2 + y^2)
    r = np.sqrt(x_vals**2 + y_vals**2)
    # Apply a small epsilon to avoid log10(0) if distance is 0
    r = np.maximum(r, 1e-3)
    
    # Relative RCS computation
    rcs_vals = snr_vals + 40 * np.log10(r)
    return rcs_vals

def _extract_frame_features(frame_data, velocity_thresh=0.1):
    """
    Extract features from a single radar frame.
    Returns feature list or None if frame should be skipped.
    """
    body = frame_data.objects if hasattr(frame_data, 'objects') else []
    
    num_objs = frame_data.num_objects if hasattr(frame_data, 'num_objects') else 0
    if num_objs == 0:
        return [0, 0, 0, 0, 0, 0, 0, 0, 0]
    
    # Initialize defaults
    avg_x = range_x = avg_y= std_vel = max_snr = avg_snr = avg_rcs = max_rcs = spatial_extent = 0.0
    
    snr_threshold = 100
    x_ceil = 1.5
    snr_ceil = 700

    if body:
        # Filter for moving objects within distance threshold
        moving_objs = [
            obj for obj in body if 
            abs(obj.velocity) > velocity_thresh 
            and abs(obj.x) < x_ceil
            #and obj.snr > snr_threshold
			#and obj.snr < snr_ceil
        ]

        moving_objs = _remove_outliers(moving_objs, m=1.0)
        
        if len(moving_objs) > 2: # DBSCAN needs at least 3 points for min_samples=3
                coords = np.array([[obj.x, obj.y] for obj in moving_objs])
                
                # eps: max distance between points to be neighbors (e.g., 0.5 meters)
                # min_samples: min points to form a core cluster
                db = DBSCAN(eps=0.3, min_samples=3).fit(coords)
                labels = db.labels_

                # Find the largest cluster (ignoring outliers labeled -1)
                unique_labels, counts = np.unique(labels[labels != -1], return_counts=True)
                
                if len(counts) > 0:
                    # Identify the label of the largest cluster
                    largest_cluster_label = unique_labels[np.argmax(counts)]
                    
                    # Filter objects to keep only those in the largest cluster
                    moving_objs = [obj for obj, label in zip(moving_objs, labels) if label == largest_cluster_label]
                else:
                    # All points were classified as outliers
                    moving_objs = []
        
        
        if moving_objs:
            xvals = np.array([obj.x for obj in moving_objs])
            yvals = np.array([obj.y for obj in moving_objs])
            velocities = np.array([obj.velocity for obj in moving_objs])
            snr_vals = np.array([obj.snr for obj in moving_objs])
            
            avg_x = np.mean(xvals)
            range_x = np.ptp(xvals)
            avg_y = np.mean(yvals)
            std_vel = np.var(velocities)
            max_snr = np.max(snr_vals)
            avg_snr = np.mean(snr_vals)
            
            rcs_vals = compute_rcs(xvals, yvals, snr_vals)
            avg_rcs = np.mean(rcs_vals)
            max_rcs = np.max(rcs_vals)
            
        spatial_extent = avg_y * range_x
    
    return [num_objs, avg_x, range_x, std_vel, max_snr, avg_snr, avg_rcs, max_rcs, spatial_extent]

def _aggressive_smoothing(data, window_length=15, polyorder=3):
    """
    Applies aggressive smoothing using a Savitzky-Golay filter.
    This is preferred for position data before differentiation (acceleration)
    because it preserves signal peaks better than a simple moving average.
    
    Args:
        window_length: Length of the filter window (must be odd).
        polyorder: Order of the polynomial used to fit the samples.
    """
    if len(data) < window_length:
        return data # Not enough data to smooth effectively
    
    # Ensure window_length is odd as required by savgol_filter
    if window_length % 2 == 0:
        window_length += 1
        
    return savgol_filter(data, window_length, polyorder)

def _compute_kinematics(features_array, frame_rate=20, smooth_window=15):
    """
    Compute vertical velocity and acceleration by differentiating the Avg X feature.
    
    Since the IWR1642 is oriented sideways (X is physical Z/height), 
    Doppler Velocity measures radial movement (e.g. walking towards the radar). 
    By differentiating Avg X (Height) instead, we isolate vertical acceleration 
    and velocity to prevent false positives caused by walking/running.
    """
    n_frames = len(features_array)
    if n_frames < 2:
        return np.zeros(n_frames), np.zeros(n_frames)
    
    # Extract Avg X (Feature at index 1 is height)
    raw_height = features_array[:, 1] 
    
    # 1. Median filter to drop sudden, single-frame noise spikes in radar height
    med_window = min(5, n_frames)
    if med_window % 2 == 0:
        med_window -= 1
    if med_window >= 3:
        raw_height = medfilt(raw_height, kernel_size=med_window)
    
    # Ensure window is smaller than data length and odd.
    if len(raw_height) < smooth_window:
        smooth_window = len(raw_height)
    if smooth_window % 2 == 0:
        smooth_window -= 1
    
    # Ensure polyorder is less than window length.
    polyorder = 3
    if smooth_window <= polyorder:
        return np.zeros(n_frames), np.zeros(n_frames) # Not enough data to calculate kin reliably.

    # 2. Compute smooth vertical velocity (Analytic 1st Derivative)
    vert_vel = savgol_filter(raw_height, window_length=smooth_window, polyorder=polyorder, deriv=1, delta=1/frame_rate)
    
    # 3. Compute smooth vertical acceleration (Analytic 2nd Derivative)
    vert_accel = savgol_filter(raw_height, window_length=smooth_window, polyorder=polyorder, deriv=2, delta=1/frame_rate)
    return vert_vel, vert_accel

def dataprep_queue(data_queue, smooth_window=5):
    """
    Loads radar data from the specified JSON file, extracts features from each
    frame, applies smoothing, and computes derived features.

    Args:
        filepath (str): The path to the JSON data file.
        smooth_window (int): Window size for moving average smoothing (default 5).
                            Set to 1 or None to disable smoothing.

    Returns:
        list: A 2D list where each row is a feature vector for a single frame.
              Features: [num_objs, avg_x, range_x, avg_vel, std_vel, max_vel, min_vel, max_snr, accel]
              Returns None if file not found or error occurs.
    """
    
    if len(data_queue) == 0:
        print ("Warning: Data queue is empty.")
        return None

    # --- Feature indices ---
    IDX_AVG_X = 1

    # --- Extract features from each frame ---
    all_frame_features = []
    for frame_data in list(data_queue):
        features = _extract_frame_features(frame_data)
        if features is not None:
            all_frame_features.append(features)

    # Convert to numpy array for vectorized operations
    features_array = np.array(all_frame_features, dtype=np.float64)
    
    # --- Interpolate NaN values ---
    for col in [IDX_AVG_X]:
        features_array[:, col] = _interpolate_nans(features_array[:, col])

    # Make height relative to the starting position
    features_array[:, IDX_AVG_X] = features_array[:, IDX_AVG_X] - features_array[0, IDX_AVG_X]

    # --- Compute kinematics ---
    vert_vel, accel = _compute_kinematics(features_array, smooth_window=15)

    # --- Combine features with kinematics ---
    features_final = np.column_stack([features_array, vert_vel, accel])

    # --- Apply moving average smoothing ---
    if smooth_window and smooth_window > 1:
        for i in range(features_final.shape[1]):
            features_final[:, i] = _moving_average(features_final[:, i], smooth_window)
            
    return features_final.tolist()
    
def data_diagnostic(
    queue,
    num_features,
    feature_names=['num_objs', 'avg_x', 'range_x', 'avg_y', 'avg_vel', 'std_vel', 'max_vel','min_vel','max_snr','avg_snr','vert_vel','accel']
):
    
    print("\n--- Features Diagnostic ---")
    features = {i: [] for i in range(num_features)}

    raw = dataprep_queue(queue)
    if raw is None:
        print("No data to analyze.")
        return
    for frame in raw:
        for i in range(num_features):
            features[i].append(frame[i])

    print(f"\n{'Feature':<12} {'Feature Mean':>12}")
    print("-" * 26)
    for i, name in enumerate(feature_names):
        feature_mean = np.mean(features[i])
        print(f"{name:<12} {feature_mean:>12.3f}")
