preston11-tamu/ECEN404-2026SP-Team-61-HARD/SBC-Radar/radar/parser_mmw_demo.py

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
# import the required Python packages
import struct
import math
import binascii
import codecs

# definations for parser pass/fail
TC_PASS   =  0
TC_FAIL   =  1

def getUint32(data):
    """!
       This function coverts 4 bytes to a 32-bit unsigned integer.

        @param data : 1-demension byte array  
        @return     : 32-bit unsigned integer
    """ 
    return (data[0] +
            data[1]*256 +
            data[2]*65536 +
            data[3]*16777216)

def getUint16(data):
    """!
       This function coverts 2 bytes to a 16-bit unsigned integer.

        @param data : 1-demension byte array
        @return     : 16-bit unsigned integer
    """ 
    return (data[0] +
            data[1]*256)

def getHex(data):
    """!
       This function coverts 4 bytes to a 32-bit unsigned integer in hex.

        @param data : 1-demension byte array
        @return     : 32-bit unsigned integer in hex
    """ 
    return (binascii.hexlify(data[::-1]))

def checkMagicPattern(data):
    """!
       This function check if data arrary contains the magic pattern which is the start of one mmw demo output packet.  

        @param data : 1-demension byte array
        @return     : 1 if magic pattern is found
                      0 if magic pattern is not found 
    """ 
    found = 0
    if (data[0] == 2 and data[1] == 1 and data[2] == 4 and data[3] == 3 and data[4] == 6 and data[5] == 5 and data[6] == 8 and data[7] == 7):
        found = 1
    return (found)
          
def parser_helper(data, readNumBytes):
    """!
       This function is called by parser_one_mmw_demo_output_packet() function or application to read the input buffer, find the magic number, header location, the length of frame, the number of detected object and the number of TLV contained in this mmw demo output packet.

        @param data                   : 1-demension byte array holds the the data read from mmw demo output. It ignorant of the fact that data is coming from UART directly or file read.  
        @param readNumBytes           : the number of bytes contained in this input byte array  
            
        @return headerStartIndex      : the mmw demo output packet header start location
        @return totalPacketNumBytes   : the mmw demo output packet lenght           
        @return numDetObj             : the number of detected objects contained in this mmw demo output packet          
        @return numTlv                : the number of TLV contained in this mmw demo output packet           
        @return subFrameNumber        : the sbuframe index (0,1,2 or 3) of the frame contained in this mmw demo output packet
    """ 

    headerStartIndex = -1

    for index in range (readNumBytes):
        if checkMagicPattern(data[index:index+8:1]) == 1:
            headerStartIndex = index
            break
  
    if headerStartIndex == -1: # does not find the magic number i.e output packet header 
        totalPacketNumBytes = -1
        numDetObj           = -1
        numTlv              = -1
        subFrameNumber      = -1
        platform            = -1
        frameNumber         = -1
        timeCpuCycles       = -1
    else: # find the magic number i.e output packet header 
        totalPacketNumBytes = getUint32(data[headerStartIndex+12:headerStartIndex+16:1])
        platform            = getHex(data[headerStartIndex+16:headerStartIndex+20:1])
        frameNumber         = getUint32(data[headerStartIndex+20:headerStartIndex+24:1])
        timeCpuCycles       = getUint32(data[headerStartIndex+24:headerStartIndex+28:1])
        numDetObj           = getUint32(data[headerStartIndex+28:headerStartIndex+32:1])
        numTlv              = getUint32(data[headerStartIndex+32:headerStartIndex+36:1])
        subFrameNumber      = getUint32(data[headerStartIndex+36:headerStartIndex+40:1])
        
    #print("headerStartIndex    = %d" % (headerStartIndex))
    #print("totalPacketNumBytes = %d" % (totalPacketNumBytes))
    #print("platform            = %s" % (platform)) 
    #print("frameNumber         = %d" % (frameNumber)) 
    #print("timeCpuCycles       = %d" % (timeCpuCycles))   
    #print("numDetObj           = %d" % (numDetObj)) 
    #print("numTlv              = %d" % (numTlv))
    #print("subFrameNumber      = %d" % (subFrameNumber))   
                              
    return (headerStartIndex, totalPacketNumBytes, numDetObj, numTlv, subFrameNumber)


def parser_one_mmw_demo_output_packet(data, readNumBytes):
    """!
       This function is called by application. Firstly it calls parser_helper() function to find the start location of the mmw demo output packet, then extract the contents from the output packet.
       Each invocation of this function handles only one frame at a time and user needs to manage looping around to parse data for multiple frames.

        @param data                   : 1-demension byte array holds the the data read from mmw demo output. It ignorant of the fact that data is coming from UART directly or file read.  
        @param readNumBytes           : the number of bytes contained in this input byte array  
            
        @return result                : parser result. 0 pass otherwise fail
        @return headerStartIndex      : the mmw demo output packet header start location
        @return totalPacketNumBytes   : the mmw demo output packet lenght           
        @return numDetObj             : the number of detected objects contained in this mmw demo output packet          
        @return numTlv                : the number of TLV contained in this mmw demo output packet           
        @return subFrameNumber        : the sbuframe index (0,1,2 or 3) of the frame contained in this mmw demo output packet
        @return detectedX_array       : 1-demension array holds each detected target's x of the mmw demo output packet
        @return detectedY_array       : 1-demension array holds each detected target's y of the mmw demo output packet
        @return detectedZ_array       : 1-demension array holds each detected target's z of the mmw demo output packet
        @return detectedV_array       : 1-demension array holds each detected target's v of the mmw demo output packet
        @return detectedRange_array   : 1-demension array holds each detected target's range profile of the mmw demo output packet
        @return detectedAzimuth_array : 1-demension array holds each detected target's azimuth of the mmw demo output packet
        @return detectedElevAngle_array : 1-demension array holds each detected target's elevAngle of the mmw demo output packet
        @return detectedSNR_array     : 1-demension array holds each detected target's snr of the mmw demo output packet
        @return detectedNoise_array   : 1-demension array holds each detected target's noise of the mmw demo output packet
    """

    headerNumBytes = 40   

    PI = 3.14159265

    detectedX_array = []
    detectedY_array = []
    detectedZ_array = []
    detectedV_array = []
    detectedRange_array = []
    detectedAzimuth_array = []
    detectedElevAngle_array = []
    detectedSNR_array = []
    detectedNoise_array = []

    result = TC_PASS

    # call parser_helper() function to find the output packet header start location and packet size 
    (headerStartIndex, totalPacketNumBytes, numDetObj, numTlv, subFrameNumber) = parser_helper(data, readNumBytes)
                         
    if headerStartIndex == -1:
        result = TC_FAIL
        print("************ Frame Fail, cannot find the magic words *****************")
    else:
        nextHeaderStartIndex = headerStartIndex + totalPacketNumBytes 

        if headerStartIndex + totalPacketNumBytes > readNumBytes:
            result = TC_FAIL
            print("********** Frame Fail, readNumBytes may not long enough ***********")
        elif nextHeaderStartIndex + 8 < readNumBytes and checkMagicPattern(data[nextHeaderStartIndex:nextHeaderStartIndex+8:1]) == 0:
            result = TC_FAIL
            print("********** Frame Fail, incomplete packet **********") 
        elif numDetObj <= 0:
            result = TC_FAIL
            #print("************ Frame Fail, numDetObj = %d *****************" % (numDetObj))
        elif subFrameNumber > 3:
            result = TC_FAIL
            print("************ Frame Fail, subFrameNumber = %d *****************" % (subFrameNumber))
        else: 
            # process the 1st TLV
            tlvStart = headerStartIndex + headerNumBytes
                                                    
            tlvType    = getUint32(data[tlvStart+0:tlvStart+4:1])
            tlvLen     = getUint32(data[tlvStart+4:tlvStart+8:1])       
            offset = 8
                    
            #print("The 1st TLV") 
            #print("    type %d" % (tlvType))
            #print("    len %d bytes" % (tlvLen))
                                                    
            # the 1st TLV must be type 1
            if tlvType == 1 and tlvLen < totalPacketNumBytes:#MMWDEMO_UART_MSG_DETECTED_POINTS
                         
                # TLV type 1 contains x, y, z, v values of all detect objects. 
                # each x, y, z, v are 32-bit float in IEEE 754 single-precision binary floating-point format, so every 16 bytes represent x, y, z, v values of one detect objects.    
                
                # for each detect objects, extract/convert float x, y, z, v values and calculate range profile and azimuth                           
                for obj in range(numDetObj):
                    # convert byte0 to byte3 to float x value
                    x = struct.unpack('<f', codecs.decode(binascii.hexlify(data[tlvStart + offset:tlvStart + offset+4:1]),'hex'))[0]

                    # convert byte4 to byte7 to float y value
                    y = struct.unpack('<f', codecs.decode(binascii.hexlify(data[tlvStart + offset+4:tlvStart + offset+8:1]),'hex'))[0]

                    # convert byte8 to byte11 to float z value
                    z = struct.unpack('<f', codecs.decode(binascii.hexlify(data[tlvStart + offset+8:tlvStart + offset+12:1]),'hex'))[0]

                    # convert byte12 to byte15 to float v value
                    v = struct.unpack('<f', codecs.decode(binascii.hexlify(data[tlvStart + offset+12:tlvStart + offset+16:1]),'hex'))[0]

                    # calculate range profile from x, y, z
                    compDetectedRange = math.sqrt((x * x)+(y * y)+(z * z))

                    # calculate azimuth from x, y           
                    if y == 0:
                        if x >= 0:
                            detectedAzimuth = 90
                        else:
                            detectedAzimuth = -90 
                    else:
                        detectedAzimuth = math.atan(x/y) * 180 / PI

                    # calculate elevation angle from x, y, z
                    if x == 0 and y == 0:
                        if z >= 0:
                            detectedElevAngle = 90
                        else: 
                            detectedElevAngle = -90
                    else:
                        detectedElevAngle = math.atan(z/math.sqrt((x * x)+(y * y))) * 180 / PI
                            
                    detectedX_array.append(x)
                    detectedY_array.append(y)
                    detectedZ_array.append(z)
                    detectedV_array.append(v)
                    detectedRange_array.append(compDetectedRange)
                    detectedAzimuth_array.append(detectedAzimuth)
                    detectedElevAngle_array.append(detectedElevAngle)
                                                                
                    offset = offset + 16
                # end of for obj in range(numDetObj) for 1st TLV
                                                            
            # Process the 2nd TLV
            tlvStart = tlvStart + 8 + tlvLen
                                                    
            tlvType    = getUint32(data[tlvStart+0:tlvStart+4:1])
            tlvLen     = getUint32(data[tlvStart+4:tlvStart+8:1])      
            offset = 8
                    
            #print("The 2nd TLV") 
            #print("    type %d" % (tlvType))
            #print("    len %d bytes" % (tlvLen))
                                                            
            if tlvType == 7: 
                
                # TLV type 7 contains snr and noise of all detect objects.
                # each snr and noise are 16-bit integer represented by 2 bytes, so every 4 bytes represent snr and noise of one detect objects.    
            
                # for each detect objects, extract snr and noise                                            
                for obj in range(numDetObj):
                    # byte0 and byte1 represent snr. convert 2 bytes to 16-bit integer
                    snr   = getUint16(data[tlvStart + offset + 0:tlvStart + offset + 2:1])
                    # byte2 and byte3 represent noise. convert 2 bytes to 16-bit integer 
                    noise = getUint16(data[tlvStart + offset + 2:tlvStart + offset + 4:1])

                    detectedSNR_array.append(snr)
                    detectedNoise_array.append(noise)
                                                                    
                    offset = offset + 4
            else:
                for obj in range(numDetObj):
                    detectedSNR_array.append(0)
                    detectedNoise_array.append(0)
            # end of if tlvType == 7

            #print("                  x(m)         y(m)         z(m)        v(m/s)    Com0range(m)  azimuth(deg)  elevAngle(deg)  snr(0.1dB)    noise(0.1dB)")
            #for obj in range(numDetObj):
            #    print("    obj%3d: %12f %12f %12f %12f %12f %12f %12d %12d %12d" % (obj, detectedX_array[obj], detectedY_array[obj], detectedZ_array[obj], detectedV_array[obj], detectedRange_array[obj], detectedAzimuth_array[obj], detectedElevAngle_array[obj], detectedSNR_array[obj], detectedNoise_array[obj]))

    return (result, headerStartIndex, totalPacketNumBytes, numDetObj, numTlv, subFrameNumber, detectedX_array, detectedY_array, detectedZ_array, detectedV_array, detectedRange_array, detectedAzimuth_array, detectedElevAngle_array, detectedSNR_array, detectedNoise_array)




    
