preston11-tamu/ECEN404-2026SP-Team-61-HARD/(notices)

Notices in the files:
SBC-Radar/radar/parser_mmw_demo.py:
(C) Copyright 2020, Texas Instruments Incorporated. - www.ti.com
A PURPOSE ARE DISCLAIMED. IN NO EVENT SHALL THE COPYRIGHT OWNER OR
CONTRIBUTORS BE LIABLE FOR ANY DIRECT, INDIRECT, INCIDENTAL, SPECIAL,
EXEMPLARY, ORCONSEQUENTIAL DAMAGES (INCLUDING, BUT NOT LIMITED TO,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
